kemenril/LoRaFox/pictures/LoRaFox.jpg

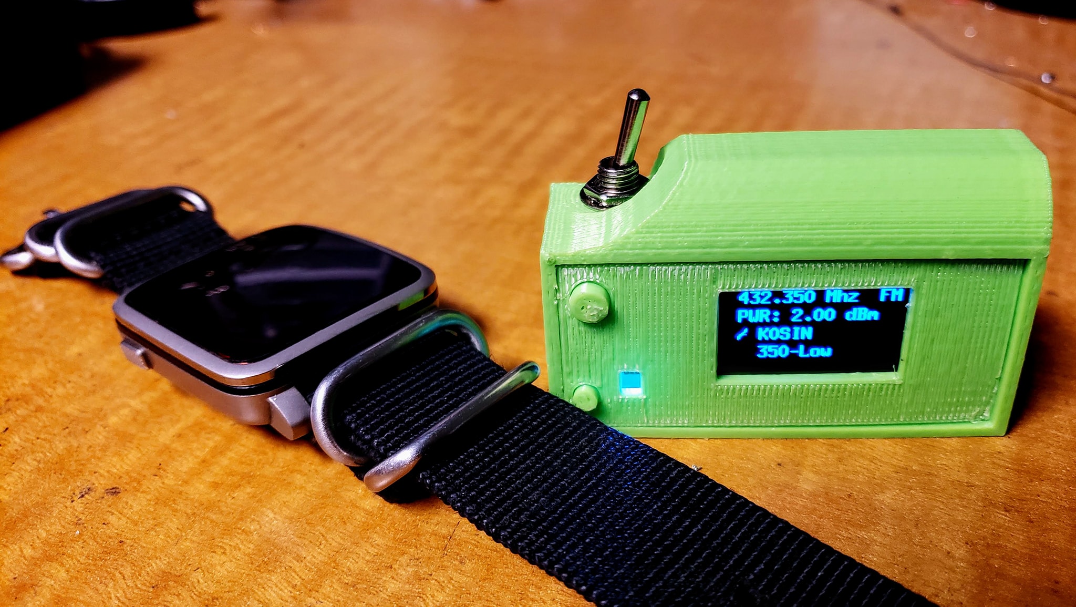
pictures/LoRaFox.jpg
