kemenril/LoRaFox/pictures/Heltec-bare-board.jpg

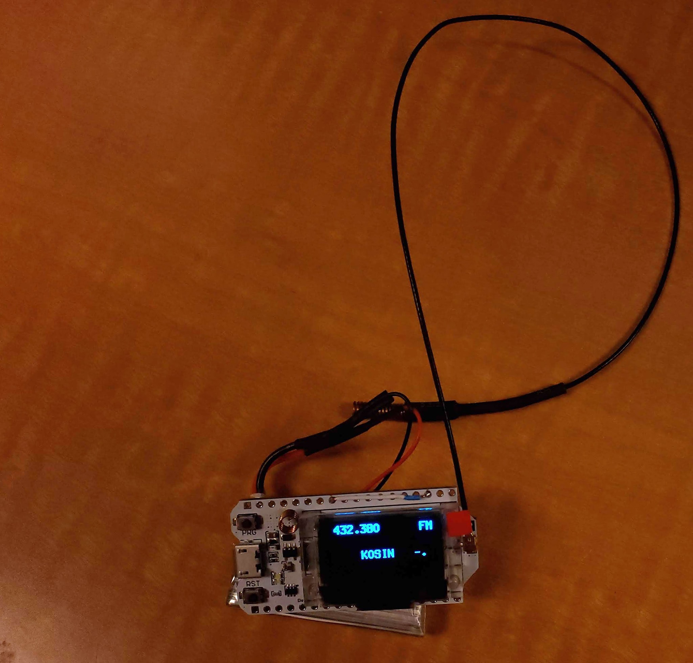
pictures/Heltec-bare-board.jpg
