kemenril/LoRaFox/schematic/schematic.jpg

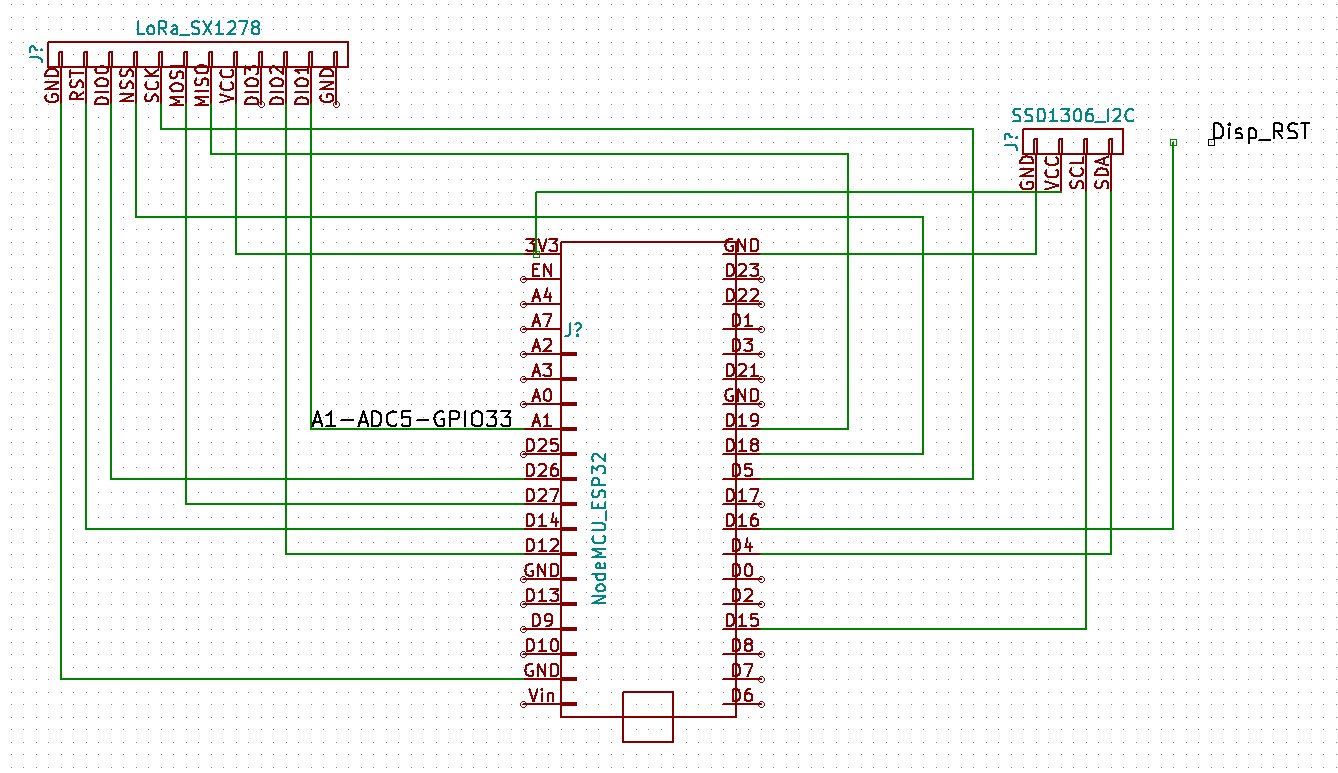
schematic/schematic.jpg
