kemenril/LoRaFox/(commit log)

2019-10-03 Initial Commit.
    [LoRaFox.kicad_pcb, LoRaFox.sch]
2019-10-04 Added an option to turn off CPU speed scaling in case your board doesn't have the option to compile for 40Mhz.
    Just #undef CPU_SCALING in the sketch and the CPU will always expect to run at the compiled-in speed.
    This allows us to use the TTGO V1 board type, for example, without trouble.
    [LoRaFox.ino]
